Jozwolf/ARMAC-fire-defence/(commit log)

2026-11-02 Add current AR1, AR2 and AR3 sketches with README and config template
    Snapshot of the working code as of 2 November 2026 (watchdog, restart
    safety, shed cooling and gel-flow fixes). Site credentials live in
    config.h, which is not committed; see config_example.h.
2026-11-07 Update AR1, AR2 and AR3 to 7 Nov 2026 code; README notes on comms and TestSys pins
    Comms: CRC-8 frame checks with optional rejection (FRAME_REJECT), backup-link
    receive fixes, 60 s steady-RS485 return from backup, framed ACK/HB from AR3.
    AR2: tank level de-glitch, temperature probe address swap.
    AR3: button test start reaches AR1 over backup.
